watalabo/backscatter-15.4/Backscatter_TAG_Ant_Dbg_Assy.pdf

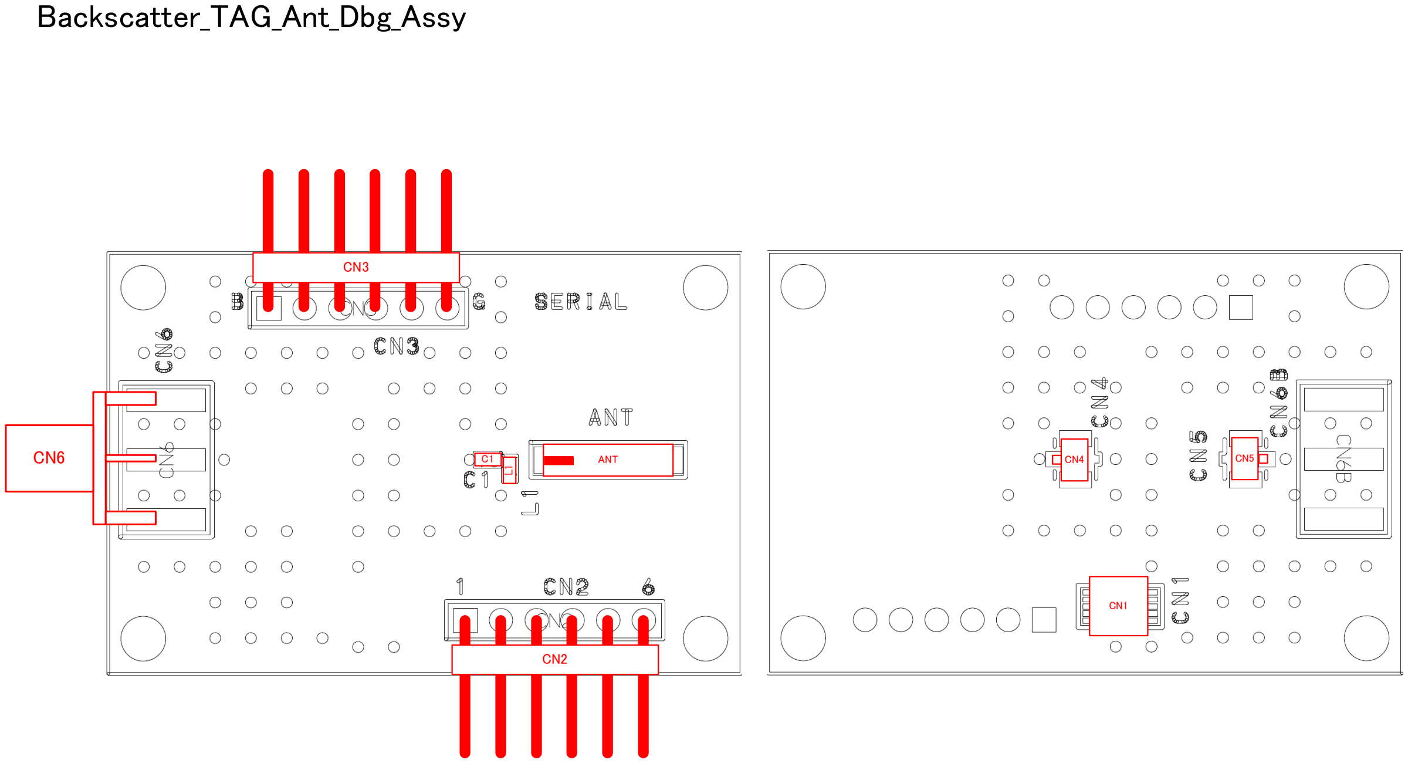
[picture p7: page 1]

Backscatter_TAG_Ant_Dbg_Assy

CN6

CN2

CN3

C1 | ANT | CN4 | CN5

CN1
