watalabo/backscatter-15.4/Backscatter_TAG_Main_Scheme.pdf

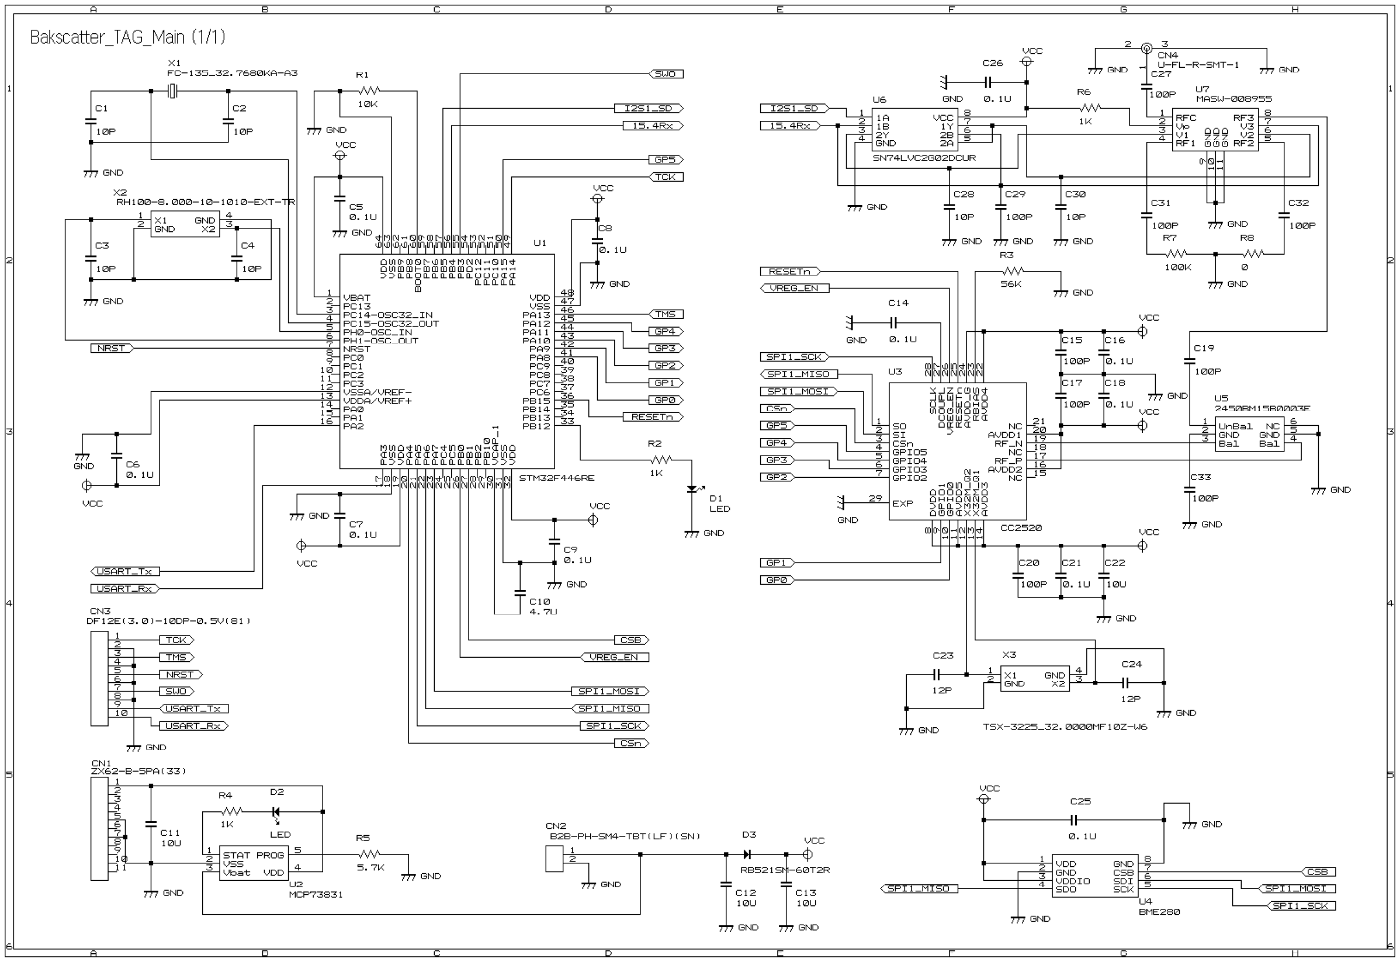
[picture p8: page 1]
