watalabo/backscatter-15.4/BackscatterTAG_Ant_Dbg_Scheme.pdf

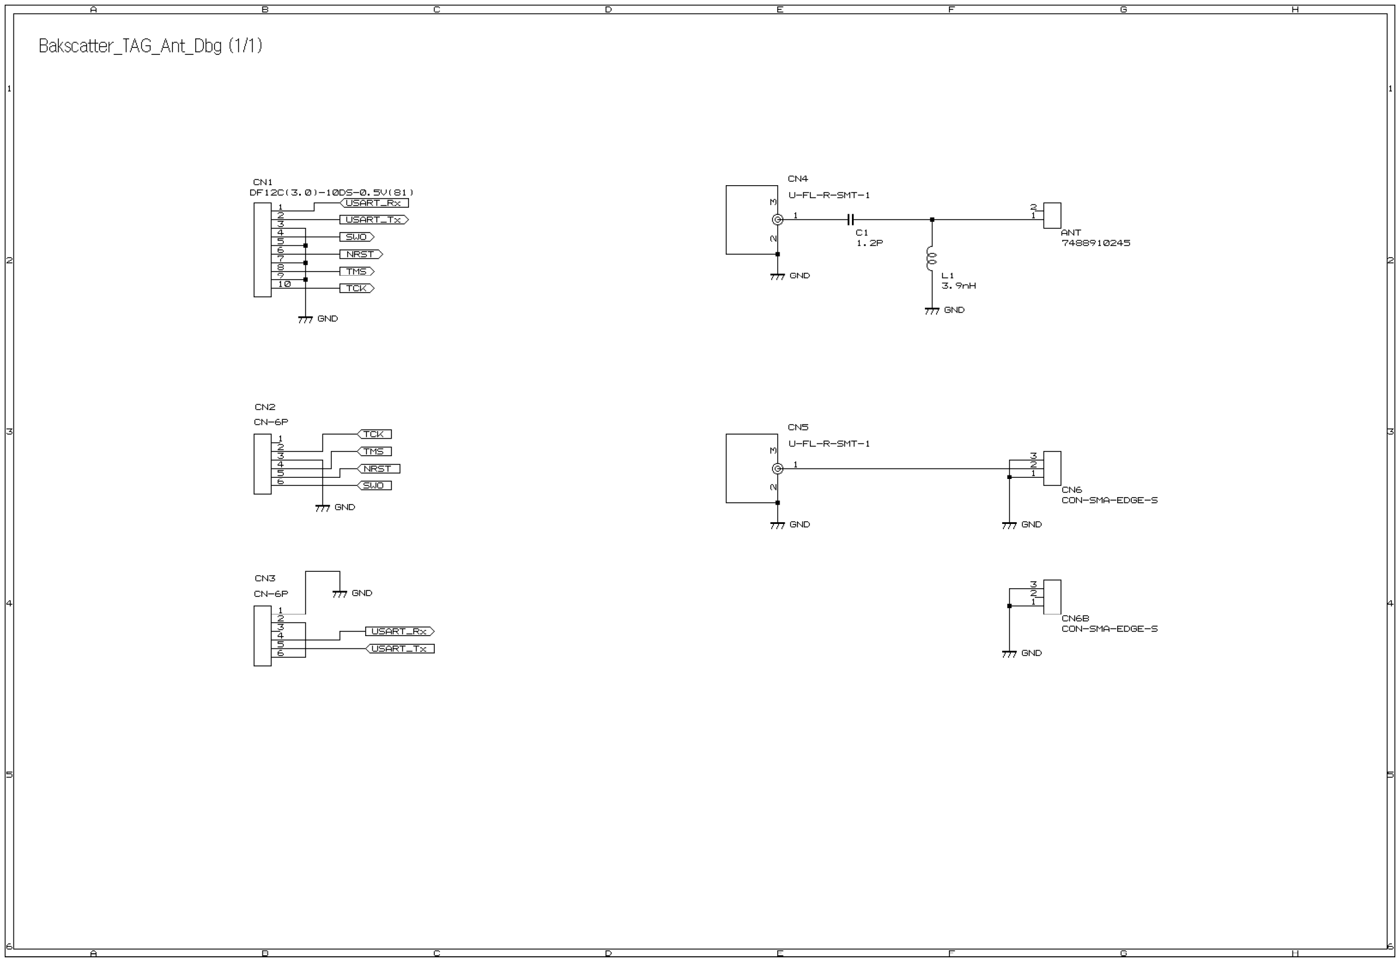
[picture p9: page 1]
