watalabo/backscatter-15.4/Backscatter_TAG_Ant_Dbg_Parts.xls

Sheet: 必ずお読みください
入力項目説明
メ ー カ ー |  |  | 電子部品のメーカー名をご入力ください。
部 品 種 別 |  |  | 電子部品の種別をご入力ください。例：チップ抵抗、トランジスタ、LED、など
電 子 部 品 型 番 |  |  | 電子部品の型番をご入力ください。 ※誤表記による不具合を回避するためにも正確なご入力をお願い致します。 ※表面実装の抵抗やコンデンサ(電解、タンタル以外)は、後述「電子部品見取り表」をご参照のうえ、ご入力ください。
配 置 記 号 / リファレンス |  |  | シルク図/配置図に表記された配置記号/リファレンス番号をご入力ください。 ※複数入力する場合は、カンマ「,」区切りでのご入力をお願い致します。 (入力例)R1～R5、R1-5と略さず、R1,R2,R3,R4,R5とご入力ください。 ※電子部品型番ベースでのご記入をお願い致します。（１つの電子部品型番に対して、配置番号を複数記入）
個 数 |  |  | 電子部品の個数をご入力ください。
ピ ン 数 |  |  | 電子部品の総ピン数をご入力ください。 ※基板取付穴、部品取付穴、全てのスルー・ノンスルーホール、面実装部品のパッド、及び次の①～⑤の配線を伴う箇所（①テストピン、②チェックランド、③引き出しランド、④ジャンパピン、⑤入出力ランドの総計。
実装 / 未実装 |  |  | 実装サービスでの「実装」/「未実装」をご選択ください。 ※同じ電子部品型番の中で実装と未実装が分かれる場合は、それぞれ2行に分けて配置記号をご入力ください。
部品分類 | SMD |  | 表面実装部品
 | DIP |  | 挿入部品
 | 特殊 BGA等 |  | BGA/CSP/LGA/QFNなど部品極性が部品の真下に配置された部品 -BGA：Ball Grid Array/下面に半田ボールの端子を配置したパッケージ。 -CSP：Chip Size Package/チッププサイズと同じか、もしくは僅かに大きいパッケージ。 -LGA：Land Grid Array/裏面に外部入出力用のランドを設けたパッケージ。※BGAの半田ボールがない。 -QFN：Quad Flat Non-Lead Package/QFPに似ていますが、外部入出力用のピンが出ていないパッケージ。
P板.com提供部品 (無料) |  |  | 【無償提供部品一覧】シートに記載されている「メーカー型番」を【部品リスト入力フォーム】シートのD列（電子部品型番）に入力し、I列（実装／未実装）を「実装」に設定いただくと、自動的に「○」が表示されます。 ※無料提供部品：チップコンデンサ/チップ抵抗を約1000種、実装サービスをご利用のお客様に無料提供いたします。 ※「○」が付かない場合は全半角の不一致などにより誤判定されている可能性があります。【無償提供部品一覧】シートより型番をコピー＆ペーストにて【部品リスト入力フォーム】にご入力ください。
 |  |  | http://www.p-ban.com/implementation/chip.html
P板.com調達部品(有料） |  |  | P板.com実装サービスで部品調達を希望される場合に○をご選択ください。 ※調達費用のお見積もりは、部品リストの返却と同時にご連絡いたします。 ※ご希望の納期や市場在庫状況によっては、調達が不可となる部品もございますので、予めご了承ください。
パッケージ情報 部品外形/部品仕様 |  |  | 電子部品のパッケージ情報をご入力ください。例：1608 , DIP , 0.5mmピッチQFP , 0.4mmピッチCN
コ メ ン ト |  |  | 特別なご指示のある電子部品について、自由にご入力ください。 例：未実装挿入穴のマスク処理が必要、など
版、変更履歴 |  |  | 部品種毎に、変更履歴を記載してください。 版は、アカウント登録の版に合わせて記載ください。
調達型式、代替型式 |  |  | 無料提供部品の在庫切れや、正確な調達型式を記載いたします。
部品名称見取り表
1.チップ部品（抵抗、コンデンサ）
 |  |  |  |  | 単位：ｍｍ
 |  |  | 電子部品型番 (C:コンデンサ、R:抵抗） | Ａ寸法 | Ｂ寸法
 |  |  | C/R1608 | 1.6 | 0.8
 |  |  | C/R2125 | 2 | 1.25
 |  |  | C/R3216 | 3.2 | 1.6
 |  |  | C/R3225 | 3.2 | 2.5
 |  |  | C/R4532 | 4.5 | 3.2
2.チップタンタルコンデンサ
 |  |  |  |  | 単位：ｍｍ
 |  |  | 電子部品型番 | Ａ寸法 | Ｂ寸法
 |  |  | CT3216 | 3.2 | 1.6
 |  |  | CT3528 | 3.5 | 2.8
 |  |  | CT4726 | 4.7 | 2.6
 |  |  | CT6032 | 6 | 3.2
 |  |  | CT5846 | 5.8 | 4.6
 |  |  | CT7343 | 7.3 | 4.3
3.チップアルミ電解コンデンサ
 |  |  |  |  |  | 単位：ｍｍ
 |  |  | 電子部品型番 | Ａ寸法 | Ｂ寸法 | C寸法
 |  |  | CE33 | 3.3 | 3.3 | φ3.0
 |  |  | CE43 | 4.3 | 4.3 | φ4.0
 |  |  | CE53 | 5.3 | 5.3 | φ5.0
 |  |  | CE66 | 6.6 | 6.6 | φ6.3
 |  |  | CE83 | 8.3 | 8.3 | φ8.0
 |  |  | CE103 | 10.3 | 10.3 | φ10.0
部品取り付け穴は、ピン数に含めてください。
コネクタの場合 |  |  |  |  |  | トランスの場合
部品リストフォーマット変更履歴
2014-02-01 | v2.0 | 松森 | 部品種別の総計を、直接関数に変更
 |  |  | ピン数合計、実装数合計数量を、直接関数に変更
 |  |  | 部品調達見積欄を修正
2014-03-11 | v2.1 | 松森 | *N列、O列が下の方、"○"選択リスト消えていたのを追加
 |  |  | *縮小しても解像度崩れず文字表示するため、フォントを"Meiryo UI"(Windows 標準添付)に変更
 |  |  | *136行目以降を非表示
 |  |  | *"X"列にリストを埋め込み
2014-06-12 | v2.2 | 松森 | *固定行を変更
 |  |  | *在庫状況列に条件付き書式設定
 |  |  | *その他各種バグ修正
2015-03-31 | V2.3 | 松森 | *無償提供部品を記載すると、無償提供部品欄に自動で"○"が表示されるよう条件式を挿入
 |  |  | *併せて、無償提供部品参照用一覧シートの作成・追加
 |  |  | *最小購入数が必要数量を下回る場合、セルを赤色にハッチングする
 |  |  | *シート1の名称変更
 |  |  | *変更履歴シートの追加
2015-06-19 | v2.4 | 松森 | ・ゼロΩ抵抗を無償対象に追加
 |  |  | ・変更履歴の列を追加し、変更履歴シートを削除
 |  |  | ・その他書式、印刷機能の変更
 |  |  | ・無償提供部品の入れ替え
2015-08-14 | v2.5 | 松森 | ・ゼロΩ抵抗の無償対象品が正しく反映されていなかったバグ修正
 |  |  | ・フォームへバージョン情報を埋め込み
2015-11-05 | v2.6 | 上田 | ・無償提供部品(RK73H2ATTD1601F)の抵抗値を正しい値に修正
2015-11-09 | v2.7 | 上田 | ・P板.com調達部品(無料)欄のフォントを変更
2016-01-15 | v2.8 | 箕浦 | ・無償提供部品一覧の「GRM32NF11E106Z」を削除
 |  |  | ・部品リスト入力フォームの4行目F列～L列の計算式が136行目以降を対象としていなかった不具合を修正
2016-01-27 | v2.9 | 箕浦 | ・「無償提供部品一覧」シートの表記修正
2016-08-26 | v2.10 | 松森 | ・「GRM31CF11E106Z」の許容差値修正
2016-11-15 | v2.11 | 松森 | ・部品調達欄表示順序変更
 |  |  | ・備考欄、荷姿欄追加
 |  |  | ・在庫状況のリスト微修正
2017-03-21 | v2.12 | 松森 | ・調達金額合計欄作成
 |  |  | ・在庫状況「長納期」を追加
 |  |  | ・その他微修正
2017-06-29 | v2.13 | 松森 | ・村田製3216サイズ以上のチップコンの取扱い中止
2017-07-19 | V2.14 | 松森 | ・KOA製1005サイズの定格電力を0.1Wに変更
 |  |  | (2015年10月のKOA仕様変更に伴う)
2017-09-14 | v2.15 | 松森 | ・KOA製2012サイズの定格電力を0.25Wへ変更
 |  |  | ・KOA製1608サイズ、1K以下の定格電力を0.125Wへ変更
 |  |  | ・MURATA製一部型式、許容差および定格修正
 |  |  | ・MURATA製一部部品削除
 |  |  | ・その他書式設定等微修正
2017-10-12 | v2.20 | 松森 | ・部品調達関連項目の移動
 |  |  | ・条件付き書式追加
2018-06-22 | v2.31 | 松森 | ・「1608」サイズと「2012」サイズのチップコンデンサを無償対象品から除外
2018-10-18 | V2.32 | 山田 | ・部品調達関連項目追加（条件付き書式追加/在庫状況：在庫少追加）
 |  |  | ・「必ずお読みください」シートの「配置記号 / リファレンス」の項目修正（配置記号の省略について）
2019-09-05 | V2.4 | 岡田 | Excelファイル名を部品表内に表記する関数追加
 |  |  | 無償提供部品型番入力後にスペースが入るとO列に丸がされない問題を修正
2019-09-10 | V2.41 | 岡田 | "AD"列にトレイ追加
2019-11-27 | V2.42 | 岡田 | D列に0(ゼロ)から始まる型番を入力すると先頭の0が消えてしまう問題あり
 |  |  | Excelの表示形式を標準から文字列に変更して問題を修正

Sheet: 部品リスト入力フォーム
partslist(Rev,2.41) |  |  | 電 子 部 品 型 番 ※半角英数字 ※サフィックスまで入力必須 | 配 置 記 号 リ フ ァ レ ン ス ※半角英数字） | 個数 | ピ ン 数 (部品取付穴 を含む） |  | 実装/ 未実装 | 部 品 分 類 |  |  | 必要数 実装枚数を入れてください。 ↓ | P板.com 提供 部品 (無料) | P板.com 調達 部品 (有料） | パッケージ情報 部品外形/部品仕様 | コ メ ン ト ※未実装挿入穴のマスク 処理が必要、など | 版 変更履歴 | 入荷数 | 返却
Backscatter_TAG_Ant_Dbg_Parts.xls
No | メーカー | 部品種別 |  |  |  | 1個 あたり | 合計 | 実装個数 | SMD | DIP | 特殊 BGA等 |  |  |  |  |  |  |  |  | P板.com部品調達使用欄
 |  |  |  |  | 9 | 33 | 39 | 9 | 8 | 1 | 0 | 1 | リスト (http://www.p-ban.com/implementation/chip.html)
例 | KOA | チップ抵抗 | RK73B2ATTD1002F | R1,R5,R9,R10 | 4 | 2 | 8 | 未実装 | SMD |  |  |  |  |  | 2012 |  | 4版 型式訂正、個数変更、 実装→未実装へ |  |  | 必要数 | 調達数 | 在庫状況 | メーカ | 調達品番 | 荷姿 | 納期 | 備考
1 □ | Hirose | コネクタ | DF12NC(3.0)-10DS-0.5V(51) | CN1 | 1 | 10 | 10 | 実装 | SMD |  |  | 1 |  | ○ |  |  |  |  | □ | 1
2 □ | Adam Tech | コネクタ | PH1RB-06-UA | CN2,CN3 | 2 | 6 | 12 | 実装 | SMD |  |  | 2 |  | ○ |  |  |  |  | □ | 2
3 □ | Hirose | コネクタ | U.FL-R-SMT-1(01) | CN4 | 1 | 3 | 3 | 実装 | SMD |  |  | 1 |  | ○ |  |  |  |  | □ | 1
4 □ | Hirose | コネクタ | U.FL-R-SMT-1(01) | CN5 | 1 | 3 | 3 | 実装 | SMD |  |  | 1 |  | ○ |  |  |  |  | □ | 1
5 □ | Linx Technologies Inc. | コネクタ | CONSMA020.062-G | CN6 | 1 | 5 | 5 | 実装 | DIP |  |  | 1 |  | ○ |  |  |  |  | □ | 1
6 □ | murata | インダクタ | LQG15HS3N9S02D | L1 | 1 | 2 | 2 | 実装 | SMD |  |  | 1 |  | ○ | 1005 |  |  |  | □ | 1
7 □ | murata | コンデンサ | GRM1555C2A1R2CA01D | C1 | 1 | 2 | 2 | 実装 | SMD |  |  | 1 |  | ○ | 1005 |  |  |  | □ | 1
8 □ | Würth Elektronik | アンテナ | 7488910245 | ANT | 1 | 2 | 2 | 実装 | SMD |  |  | 1 |  | ○ |  |  |  |  | □ | 1
9 □ |  |  |  |  |  |  |  |  |  |  |  |  |  |  |  |  |  |  | □
10 □ |  |  |  |  |  |  |  |  |  |  |  |  |  |  |  |  |  |  | □
11 □ |  |  |  |  |  |  |  |  |  |  |  |  |  |  |  |  |  |  | □
12 □ |  |  |  |  |  |  |  |  |  |  |  |  |  |  |  |  |  |  | □
13 □ |  |  |  |  |  |  |  |  |  |  |  |  |  |  |  |  |  |  | □
14 □ |  |  |  |  |  |  |  |  |  |  |  |  |  |  |  |  |  |  | □
15 □ |  |  |  |  |  |  |  |  |  |  |  |  |  |  |  |  |  |  | □
16 □ |  |  |  |  |  |  |  |  |  |  |  |  |  |  |  |  |  |  | □
17 □ |  |  |  |  |  |  |  |  |  |  |  |  |  |  |  |  |  |  | □
18 □ |  |  |  |  |  |  |  |  |  |  |  |  |  |  |  |  |  |  | □
19 □ |  |  |  |  |  |  |  |  |  |  |  |  |  |  |  |  |  |  | □
20 □ |  |  |  |  |  |  |  |  |  |  |  |  |  |  |  |  |  |  | □
21 □ |  |  |  |  |  |  |  |  |  |  |  |  |  |  |  |  |  |  | □
22 □ |  |  |  |  |  |  |  |  |  |  |  |  |  |  |  |  |  |  | □
23 □ |  |  |  |  |  |  |  |  |  |  |  |  |  |  |  |  |  |  | □
24 □ |  |  |  |  |  |  |  |  |  |  |  |  |  |  |  |  |  |  | □
25 □ |  |  |  |  |  |  |  |  |  |  |  |  |  |  |  |  |  |  | □
26 □ |  |  |  |  |  |  |  |  |  |  |  |  |  |  |  |  |  |  | □
27 □ |  |  |  |  |  |  |  |  |  |  |  |  |  |  |  |  |  |  | □
28 □ |  |  |  |  |  |  |  |  |  |  |  |  |  |  |  |  |  |  | □
29 □ |  |  |  |  |  |  |  |  |  |  |  |  |  |  |  |  |  |  | □
30 □ |  |  |  |  |  |  |  |  |  |  |  |  |  |  |  |  |  |  | □
31 □ |  |  |  |  |  |  |  |  |  |  |  |  |  |  |  |  |  |  | □
32 □ |  |  |  |  |  |  |  |  |  |  |  |  |  |  |  |  |  |  | □
33 □ |  |  |  |  |  |  |  |  |  |  |  |  |  |  |  |  |  |  | □
34 □ |  |  |  |  |  |  |  |  |  |  |  |  |  |  |  |  |  |  | □
35 □ |  |  |  |  |  |  |  |  |  |  |  |  |  |  |  |  |  |  | □
36 □ |  |  |  |  |  |  |  |  |  |  |  |  |  |  |  |  |  |  | □
37 □ |  |  |  |  |  |  |  |  |  |  |  |  |  |  |  |  |  |  | □
38 □ |  |  |  |  |  |  |  |  |  |  |  |  |  |  |  |  |  |  | □
39 □ |  |  |  |  |  |  |  |  |  |  |  |  |  |  |  |  |  |  | □
40 □ |  |  |  |  |  |  |  |  |  |  |  |  |  |  |  |  |  |  | □
41 □ |  |  |  |  |  |  |  |  |  |  |  |  |  |  |  |  |  |  | □
42 □ |  |  |  |  |  |  |  |  |  |  |  |  |  |  |  |  |  |  | □
43 □ |  |  |  |  |  |  |  |  |  |  |  |  |  |  |  |  |  |  | □
44 □ |  |  |  |  |  |  |  |  |  |  |  |  |  |  |  |  |  |  | □
45 □ |  |  |  |  |  |  |  |  |  |  |  |  |  |  |  |  |  |  | □
46 □ |  |  |  |  |  |  |  |  |  |  |  |  |  |  |  |  |  |  | □
47 □ |  |  |  |  |  |  |  |  |  |  |  |  |  |  |  |  |  |  | □
48 □ |  |  |  |  |  |  |  |  |  |  |  |  |  |  |  |  |  |  | □
49 □ |  |  |  |  |  |  |  |  |  |  |  |  |  |  |  |  |  |  | □
50 □ |  |  |  |  |  |  |  |  |  |  |  |  |  |  |  |  |  |  | □
51 □ |  |  |  |  |  |  |  |  |  |  |  |  |  |  |  |  |  |  | □
52 □ |  |  |  |  |  |  |  |  |  |  |  |  |  |  |  |  |  |  | □
53 □ |  |  |  |  |  |  |  |  |  |  |  |  |  |  |  |  |  |  | □
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
145 □ |  |  |  |  |  |  |  |  |  |  |  |  |  |  |  |  |  |  | □
146 □ |  |  |  |  |  |  |  |  |  |  |  |  |  |  |  |  |  |  | □
147 □ |  |  |  |  |  |  |  |  |  |  |  |  |  |  |  |  |  |  | □
148 □ |  |  |  |  |  |  |  |  |  |  |  |  |  |  |  |  |  |  | □

Sheet: 無償提供部品一覧
このシートの内容は変更しないでください。
メーカー型番 |  | メーカー | サイズ | 定数 | 許容差 | 定格
RK73Z1ETTP | ○ | KOA | 1005 | 0 | － | 1A
RK73H1ETTP1R00F | ○ | KOA | 1005 | 1 | ±1% | 0.1W
RK73B1ETTP1R0J | ○ | KOA | 1005 | 1 | ±5% | 0.1W
RK73H1ETTP1R10F | ○ | KOA | 1005 | 1.1 | ±1% | 0.1W
RK73B1ETTP1R1J | ○ | KOA | 1005 | 1.1 | ±5% | 0.1W
RK73H1ETTP1R20F | ○ | KOA | 1005 | 1.2 | ±1% | 0.1W
RK73B1ETTP1R2J | ○ | KOA | 1005 | 1.2 | ±5% | 0.1W
RK73H1ETTP1R30F | ○ | KOA | 1005 | 1.3 | ±1% | 0.1W
RK73B1ETTP1R3J | ○ | KOA | 1005 | 1.3 | ±5% | 0.1W
RK73H1ETTP1R50F | ○ | KOA | 1005 | 1.5 | ±1% | 0.1W
RK73B1ETTP1R5J | ○ | KOA | 1005 | 1.5 | ±5% | 0.1W
RK73H1ETTP1R60F | ○ | KOA | 1005 | 1.6 | ±1% | 0.1W
RK73B1ETTP1R6J | ○ | KOA | 1005 | 1.6 | ±5% | 0.1W
RK73H1ETTP1R80F | ○ | KOA | 1005 | 1.8 | ±1% | 0.1W
RK73B1ETTP1R8J | ○ | KOA | 1005 | 1.8 | ±5% | 0.1W
RK73H1ETTP2R00F | ○ | KOA | 1005 | 2 | ±1% | 0.1W
RK73B1ETTP2R0J | ○ | KOA | 1005 | 2 | ±5% | 0.1W
RK73H1ETTP2R20F | ○ | KOA | 1005 | 2.2 | ±1% | 0.1W
RK73B1ETTP2R2J | ○ | KOA | 1005 | 2.2 | ±5% | 0.1W
RK73H1ETTP2R40F | ○ | KOA | 1005 | 2.4 | ±1% | 0.1W
RK73B1ETTP2R4J | ○ | KOA | 1005 | 2.4 | ±5% | 0.1W
RK73H1ETTP2R70F | ○ | KOA | 1005 | 2.7 | ±1% | 0.1W
RK73B1ETTP2R7J | ○ | KOA | 1005 | 2.7 | ±5% | 0.1W
RK73H1ETTP3R00F | ○ | KOA | 1005 | 3 | ±1% | 0.1W
RK73B1ETTP3R0J | ○ | KOA | 1005 | 3 | ±5% | 0.1W
RK73H1ETTP3R30F | ○ | KOA | 1005 | 3.3 | ±1% | 0.1W
RK73B1ETTP3R3J | ○ | KOA | 1005 | 3.3 | ±5% | 0.1W
RK73H1ETTP3R60F | ○ | KOA | 1005 | 3.6 | ±1% | 0.1W
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
GRM155B11H272K | ○ | MURATA | 1005 | 2700pF | ±10% | DC50V
GRM155B11H332K | ○ | MURATA | 1005 | 3300pF | ±10% | DC50V
GRM155B11H392K | ○ | MURATA | 1005 | 3900pF | ±10% | DC50V
GRM155B11H472K | ○ | MURATA | 1005 | 4700pF | ±10% | DC50V
GRM155B11E682K | ○ | MURATA | 1005 | 6800pF | ±10% | DC25V
GRM155B11E822K | ○ | MURATA | 1005 | 8200pF | ±10% | DC25V
GRM155B11E103K | ○ | MURATA | 1005 | 0.01uF | ±10% | DC25V
GRM155B31H103K | ○ | MURATA | 1005 | 0.01uF | ±10% | DC50V
GRM155B11C153K | ○ | MURATA | 1005 | 0.015uF | ±10% | DC16V
GRM155B31H153K | ○ | MURATA | 1005 | 0.015uF | ±10% | DC50V
GRM155B11C183K | ○ | MURATA | 1005 | 0.018uF | ±10% | DC16V
GRM155B11E223K | ○ | MURATA | 1005 | 0.022uF | ±10% | DC25V
GRM155B11C223K | ○ | MURATA | 1005 | 0.022uF | ±10% | DC16V
GRM155B11A333K | ○ | MURATA | 1005 | 0.033uF | ±10% | DC10V
GRM155B31E333K | ○ | MURATA | 1005 | 0.033uF | ±10% | DC25V
GRM155B11A473K | ○ | MURATA | 1005 | 0.047uF | ±10% | DC10V
GRM155B11C473K | ○ | MURATA | 1005 | 0.047uF | ±10% | DC16V
GRM155B11A563K | ○ | MURATA | 1005 | 0.056uF | ±10% | DC10V
GRM155B11A683K | ○ | MURATA | 1005 | 0.068uF | ±10% | DC10V
GRM155B11A823K | ○ | MURATA | 1005 | 0.082uF | ±10% | DC10V
GRM155B11A104K | ○ | MURATA | 1005 | 0.1uF | ±10% | DC10V
GRM155B31C104K | ○ | MURATA | 1005 | 0.1uF | ±10% | DC16V
GRM155B31A474K | ○ | MURATA | 1005 | 0.47uF | ±10% | DC10V
GRM155B30J105K | ○ | MURATA | 1005 | 1uF | ±10% | DC6.3V
