watalabo/backscatter-15.4/(list of files, cad)

Other CAD files:
Backscatter_TAG_Main_PWB/BACKSCATTERTAG_MAIN.PLY
Backscatter_TAG_Ant_Dbg_PWB/BACKSCATTER_TAG_ANT_DBG.PLY
