watalabo/backscatter-15.4/Backscatter_TAG_Main_Assy.pdf

# Backscatter_TAG_Main_Assy

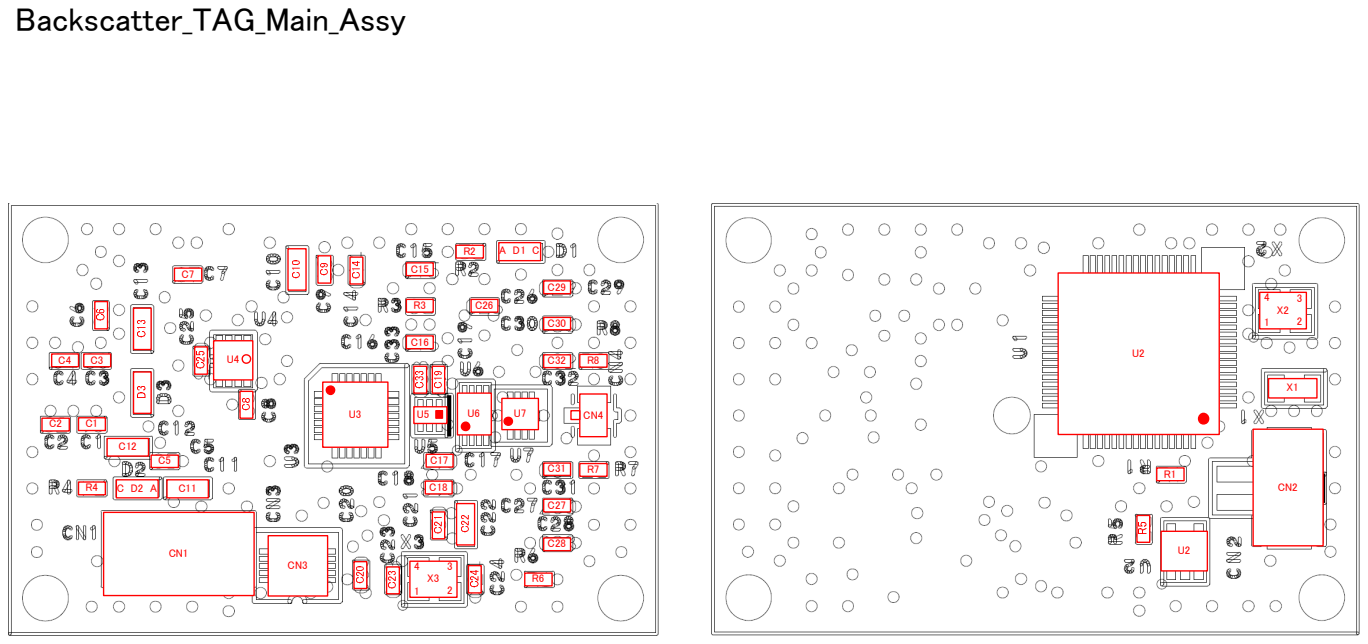
[picture p10: page 1]
