watalabo/backscatter-15.4/(list of files, drawings)

Other design files:
Backscatter_TAG_Ant_Dbg_PWB/BACKSCATTER_TAG_ANT_DBG.PCB
Backscatter_TAG_Main_PWB/BACKSCATTERTAG_MAIN.PCB
