watalabo/backscatter-15.4/(commit log)

2021-07-20 added many files.
    [BACKSCATTERTAG_MAIN.PCB, BACKSCATTERTAG_MAIN.PLY, BACKSCATTER_TAG_ANT_DBG.PCB, BACKSCATTER_TAG_ANT_DBG.PLY, Backscatter_TAG_Ant_Dbg_Parts.xls, Backscatter_TAG_Main_Parts.xls]
2021-07-27 minor update.
    [BACKSCATTERTAG_MAIN.PCB, BACKSCATTERTAG_MAIN.PLY, BACKSCATTER_TAG_ANT_DBG.PCB, BACKSCATTER_TAG_ANT_DBG.PLY]
2021-07-27 added some materials.
